rsargis/Anti-Theft-Bike-Lock/ECE 5 Poster.png

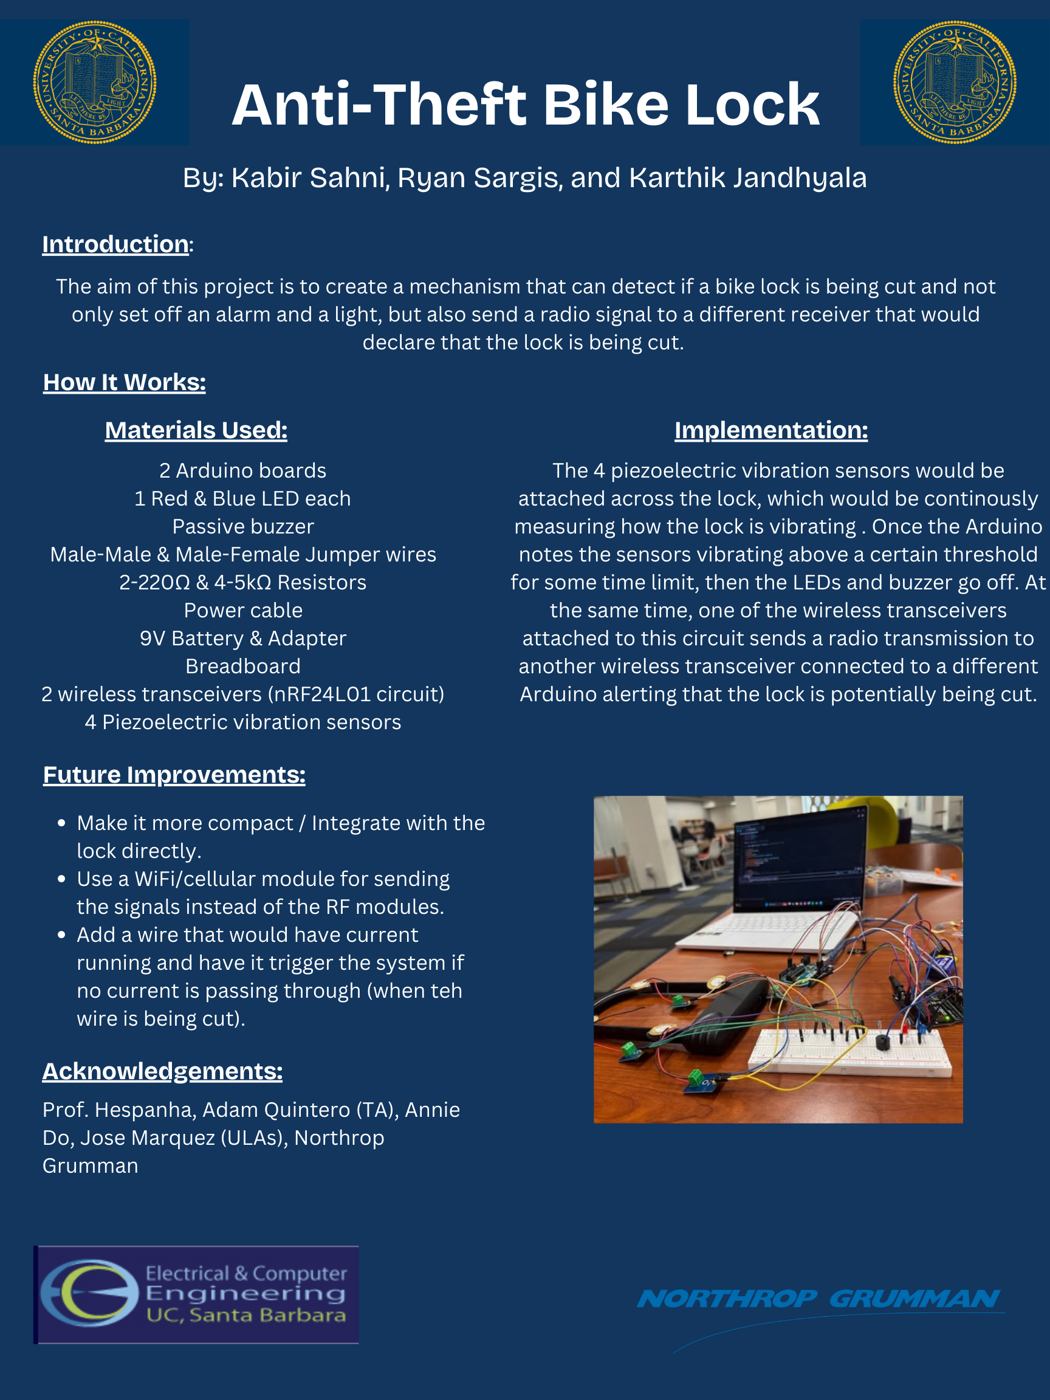
ECE 5 Poster.png
